redhotchili0909/LEDSphere/data/FET_dual_channel_summary.png

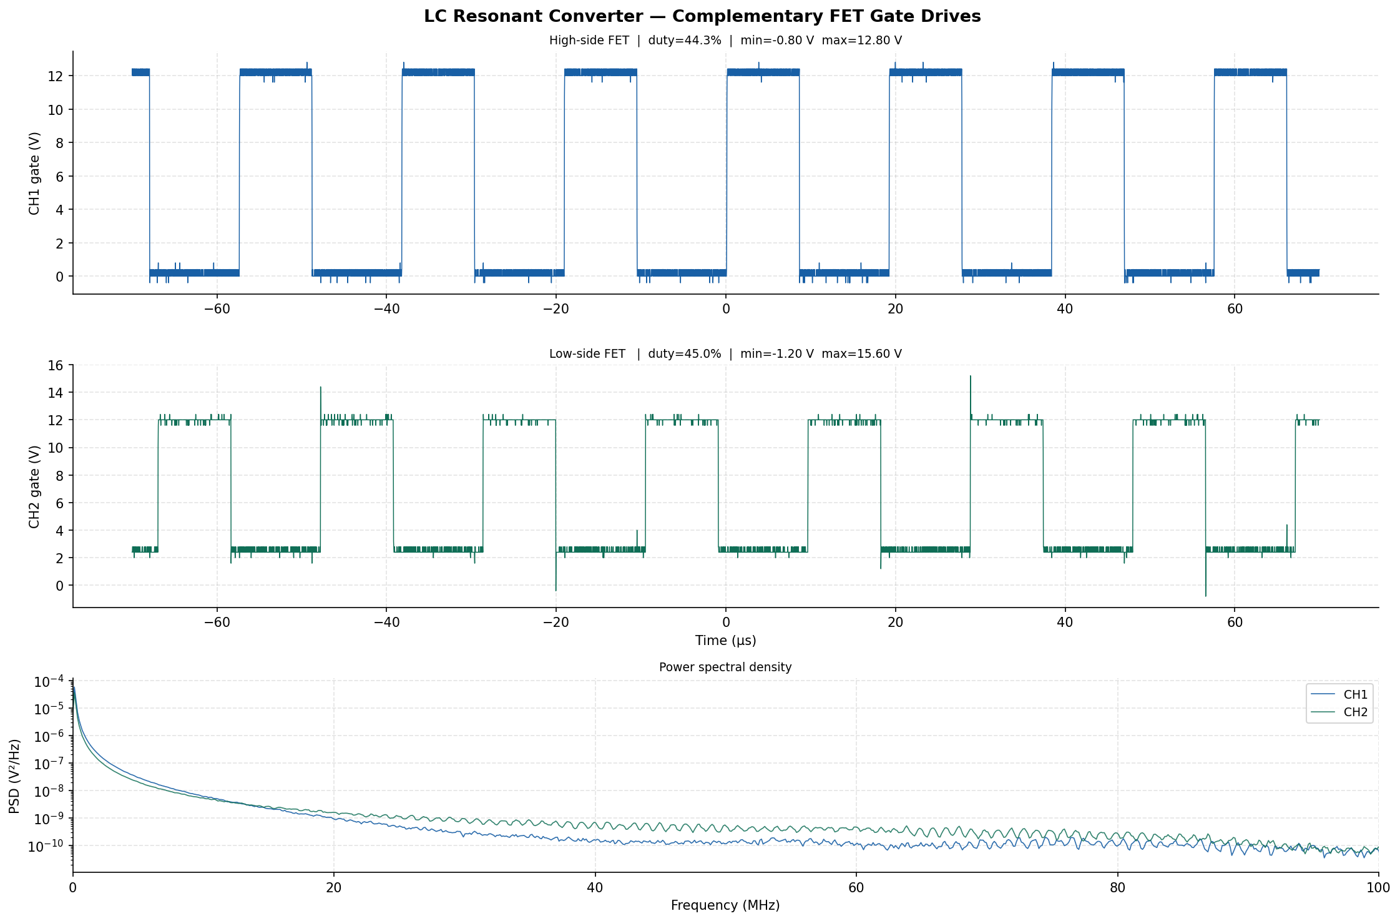
data/FET_dual_channel_summary.png
