redhotchili0909/LEDSphere/data/FET_full_analysis_summary.png

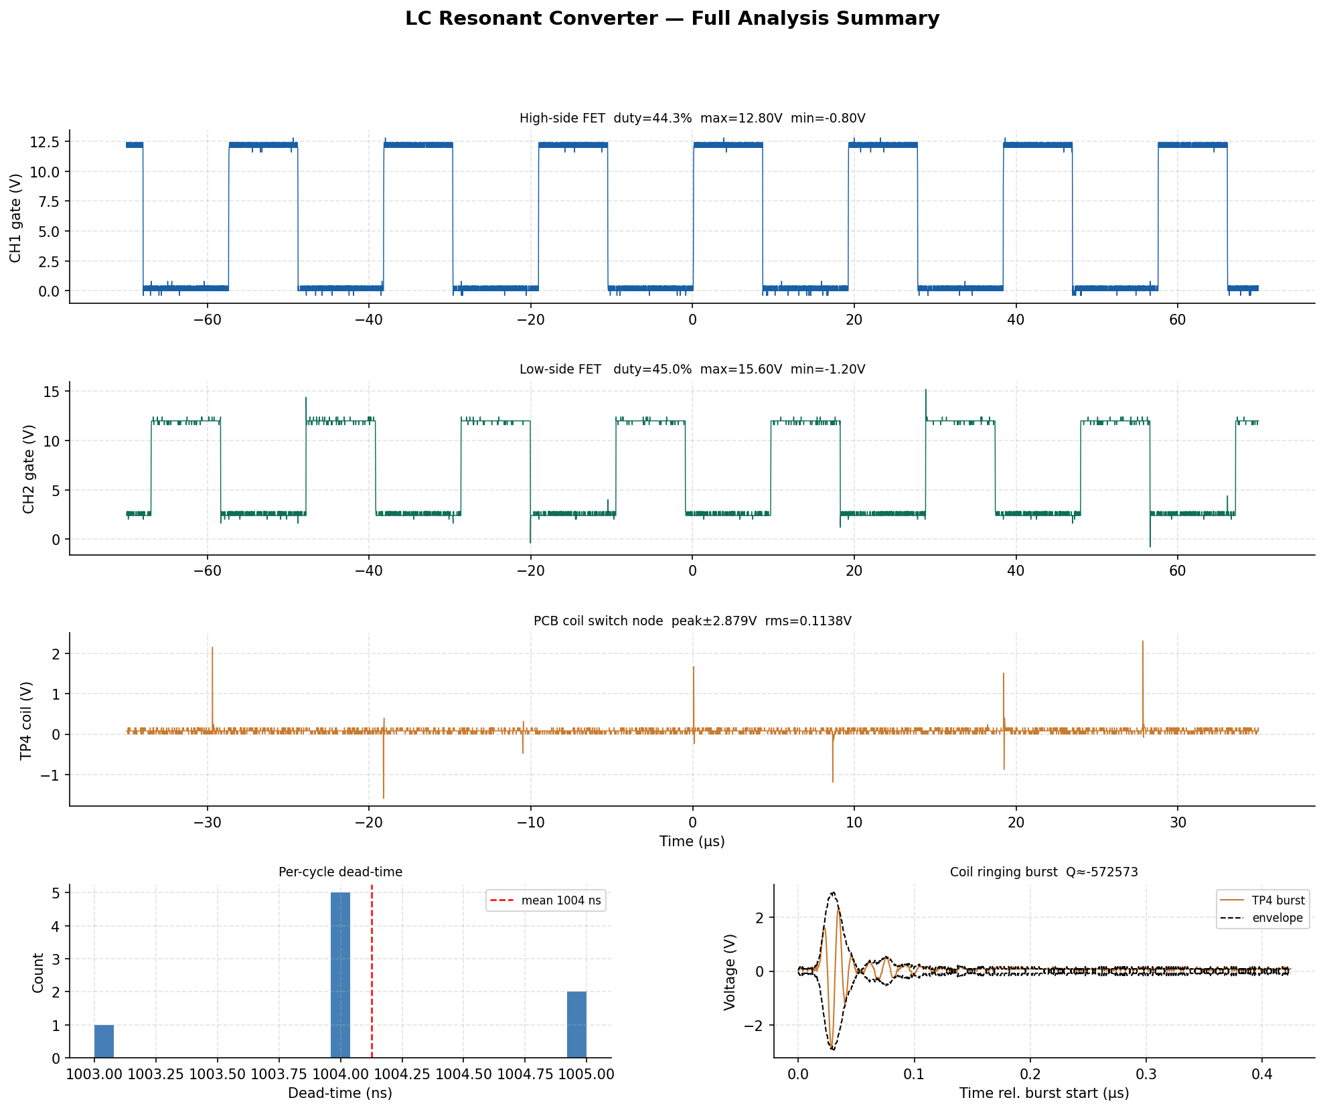
data/FET_full_analysis_summary.png
