redhotchili0909/LEDSphere/LEDSphere/pcb_models/rx.step

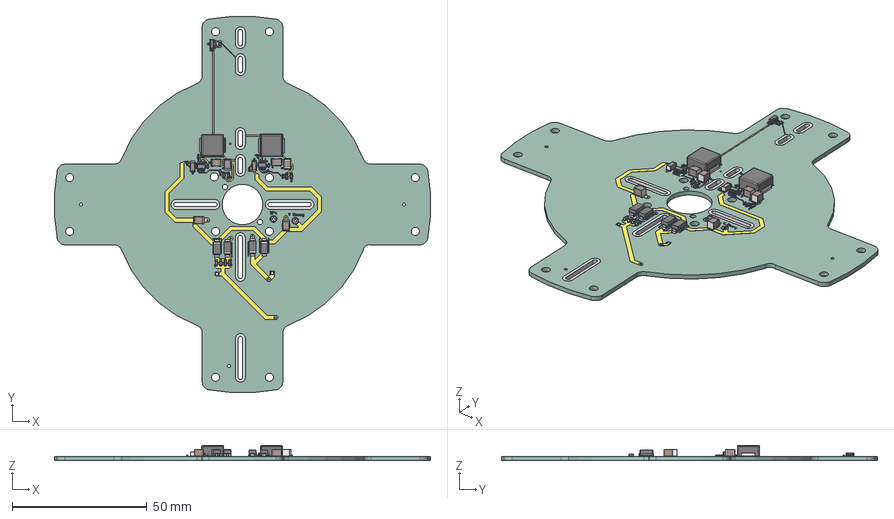
[picture p3: CAD file, 2026-04-09]
LEDSphere/pcb_models/rx.step
139.7 x 139.7 x 5.63 mm
C_1210_3225Metric x 6
C_0402_1005Metric x 7
C_0603_1608Metric x 4
D_SMA x 4
L_Vishay_IHLP-3232 x 2
R_0603_1608Metric x 5
R_0402_1005Metric x 2
TPS54202HDDCR x 2
SOT-23-3
C_1206_3216Metric x 2
power_rx_copper
power_rx_pad
power_rx_via
power_rx_silkscreen
power_rx_PCB
