redhotchili0909/LEDSphere/LEDSphere/pcb_models/support.step

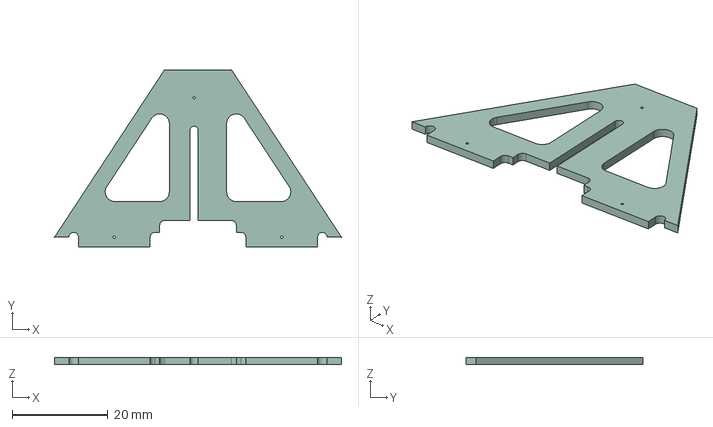
[picture p4: CAD file, 2026-04-09]
LEDSphere/pcb_models/support.step
60.0 x 37.1 x 1.51 mm
