redhotchili0909/LEDSphere/LEDSphere/Model3D/1217AS-H-150M_P3.step

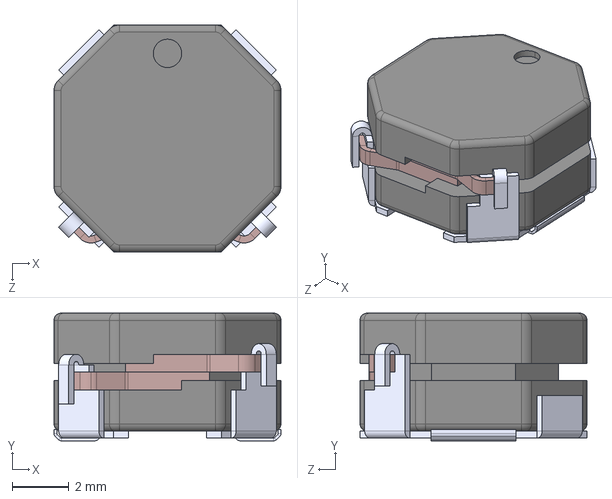
[picture p5: CAD file, 2026-04-05]
LEDSphere/Model3D/1217AS-H-150M_P3.step
8.00 x 4.50 x 8.00 mm
