redhotchili0909/LEDSphere/LEDSphere/Model3D/ASPI-0630LR-100M-T15.step

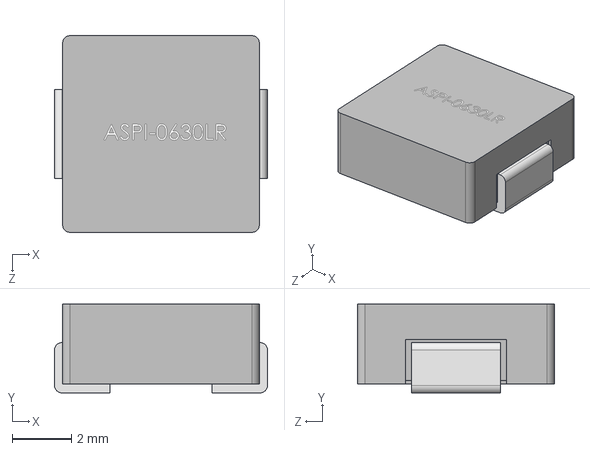
[picture p6: CAD file, 2026-04-03]
LEDSphere/Model3D/ASPI-0630LR-100M-T15.step
7.20 x 3.00 x 6.65 mm
