redhotchili0909/LEDSphere/LEDSphere/Model3D/tad05-03-1-l-g.stp

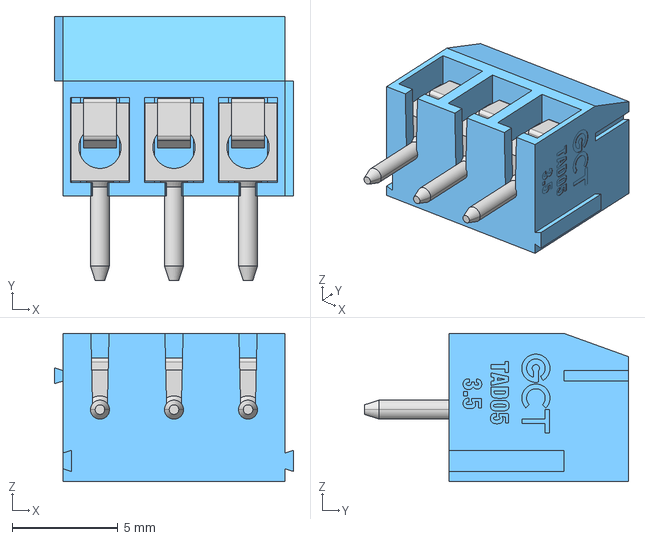
[picture p7: CAD file, 2026-04-03]
LEDSphere/Model3D/tad05-03-1-l-g.stp
11.3 x 12.5 x 7.00 mm
