redhotchili0909/LEDSphere/LEDSphere/Model3D/MSD-4-A.STEP

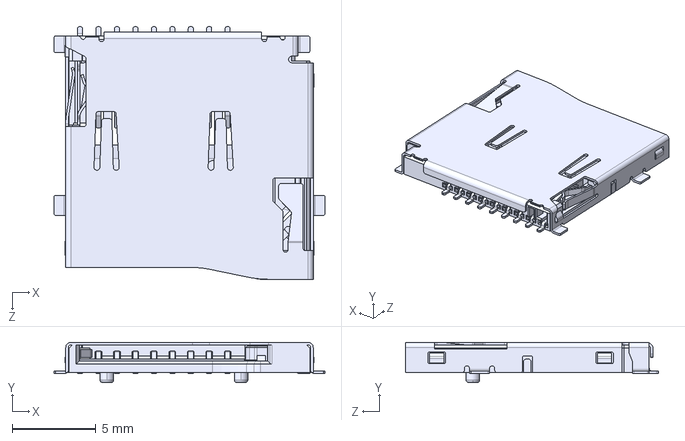
[picture p8: CAD file, 2026-04-03]
LEDSphere/Model3D/MSD-4-A.STEP
16.1 x 2.40 x 15.0 mm
