redhotchili0909/LEDSphere/LEDSphere/Model3D/SMC Package.step

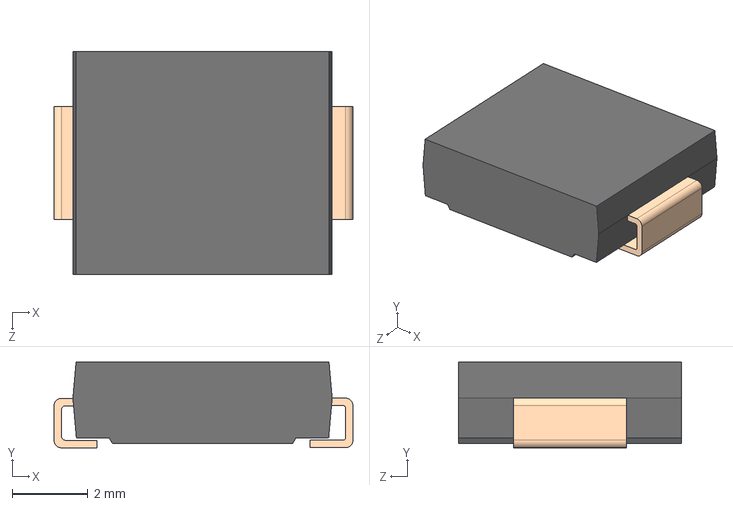
[picture p9: CAD file, 2026-04-02]
LEDSphere/Model3D/SMC Package.step
7.90 x 2.26 x 5.90 mm
