redhotchili0909/LEDSphere/LEDSphere/Model3D/D0014A.stp

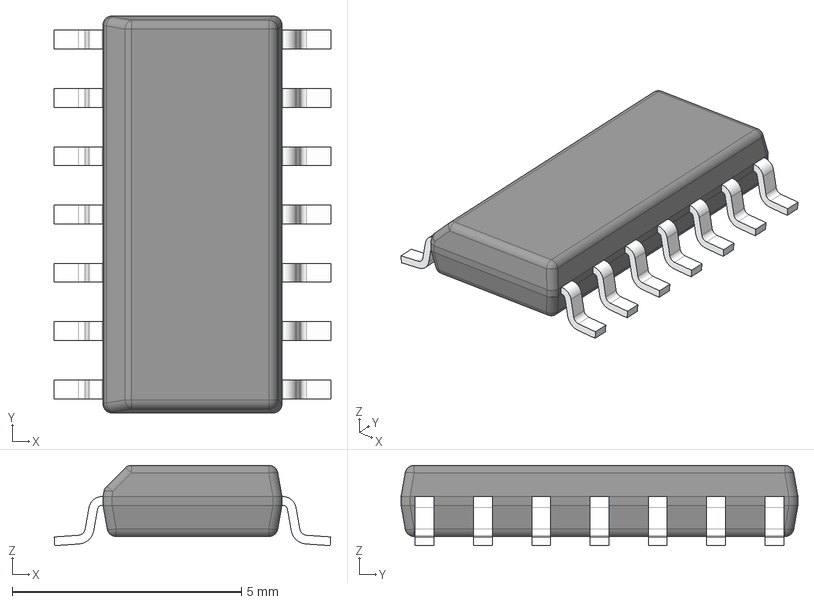
[picture p10: CAD file, 2026-04-02]
LEDSphere/Model3D/D0014A.stp
6.03 x 8.65 x 1.75 mm
BODY-SO
LEAD-SO x 14
PIN1-ID
