redhotchili0909/LEDSphere/LEDSphere/Model3D/xkb5858-w-f-75.stp

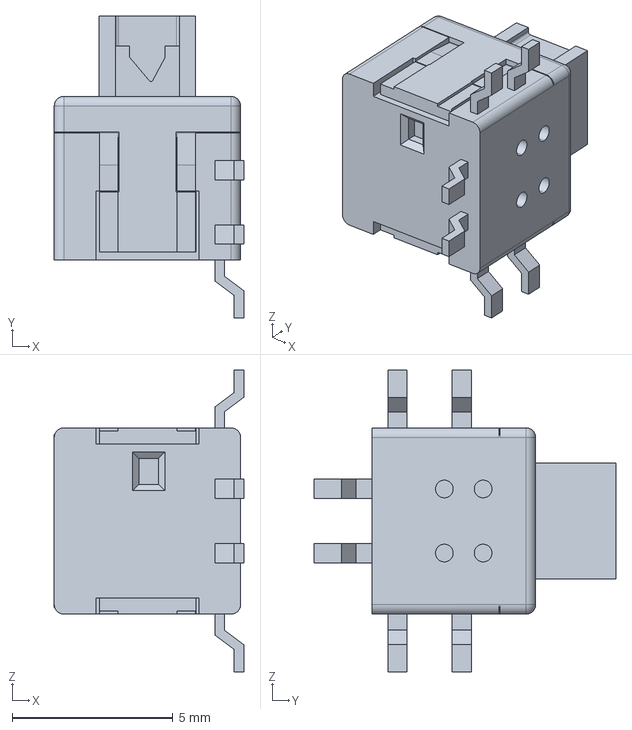
[picture p11: CAD file, 2026-04-02]
LEDSphere/Model3D/xkb5858-w-f-75.stp
5.90 x 9.40 x 9.40 mm
