redhotchili0909/LEDSphere/LEDSphere/Model3D/SO-16N_STM.step

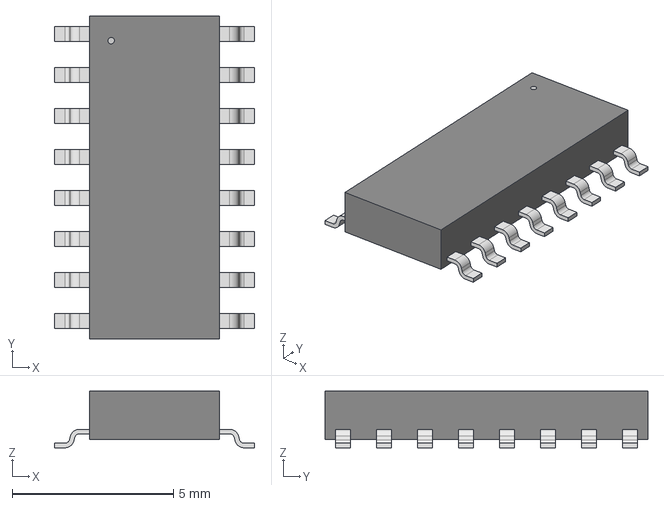
[picture p12: CAD file, 2026-04-02]
LEDSphere/Model3D/SO-16N_STM.step
6.20 x 10.0 x 1.75 mm
