redhotchili0909/LEDSphere/LEDSphere/Model3D/SRP 7028A series.stp

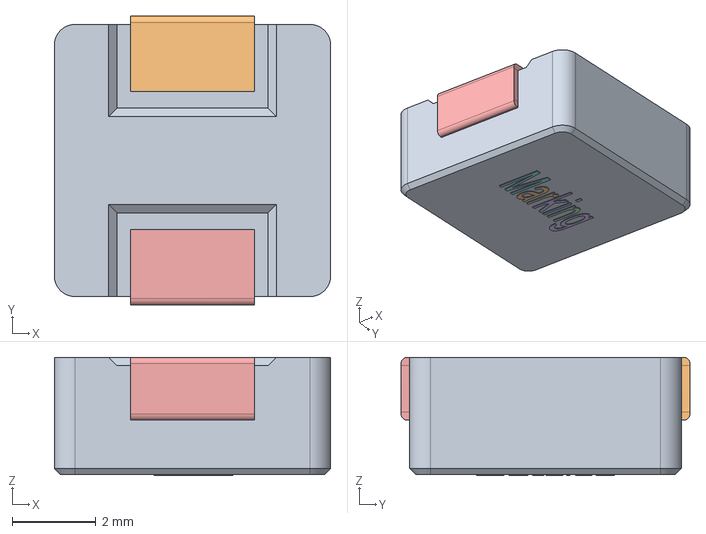
[picture p13: CAD file, 2026-04-02]
LEDSphere/Model3D/SRP 7028A series.stp
6.60 x 6.90 x 2.82 mm
