redhotchili0909/LEDSphere/LEDSphere/Model3D/D0016A.stp

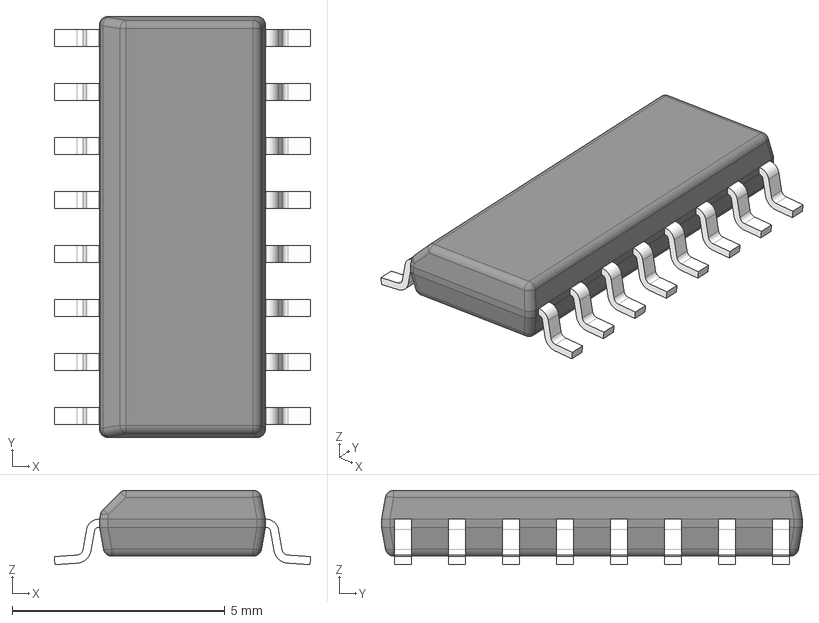
[picture p14: CAD file, 2026-04-02]
LEDSphere/Model3D/D0016A.stp
6.03 x 9.90 x 1.75 mm
BODY-SO
LEAD-SO x 16
PIN1-ID
