redhotchili0909/LEDSphere/LEDSphere/Model3D/SN74AHC1G14DBVR.step

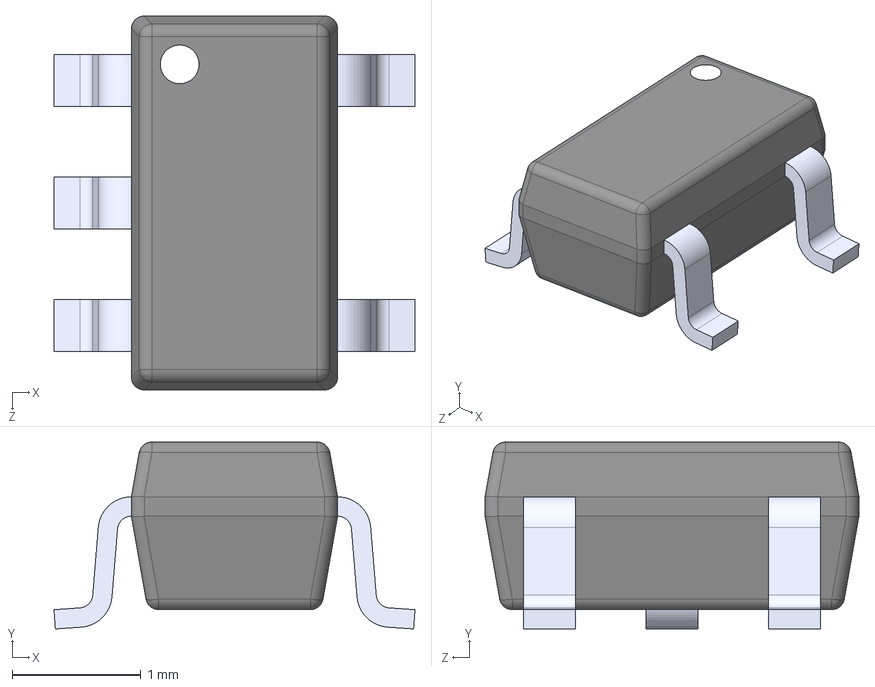
[picture p15: CAD file, 2026-04-02]
LEDSphere/Model3D/SN74AHC1G14DBVR.step
2.80 x 1.45 x 2.90 mm
