redhotchili0909/LEDSphere/LEDSphere/Model3D/UJ20-C-V-C-1-SMT-TR.STEP

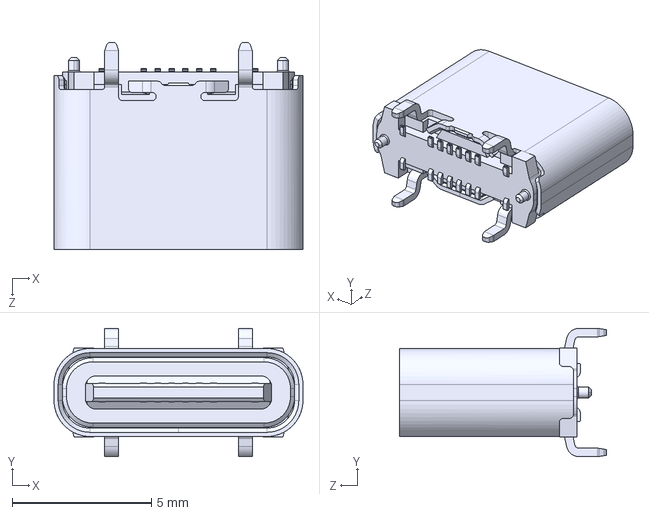
[picture p16: CAD file, 2026-03-26]
LEDSphere/Model3D/UJ20-C-V-C-1-SMT-TR.STEP
8.94 x 4.60 x 7.45 mm
