redhotchili0909/LEDSphere/LEDSphere/Model3D/SG3525AP.step

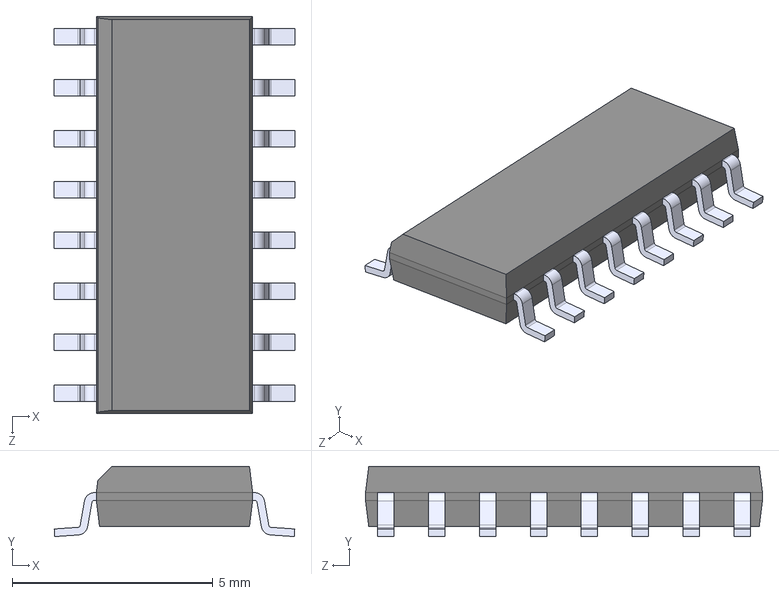
[picture p17: CAD file, 2026-03-25]
LEDSphere/Model3D/SG3525AP.step
6.00 x 1.75 x 9.90 mm
