redhotchili0909/LEDSphere/LEDSphere/Model3D/QFPN_491KCU6_STM.step

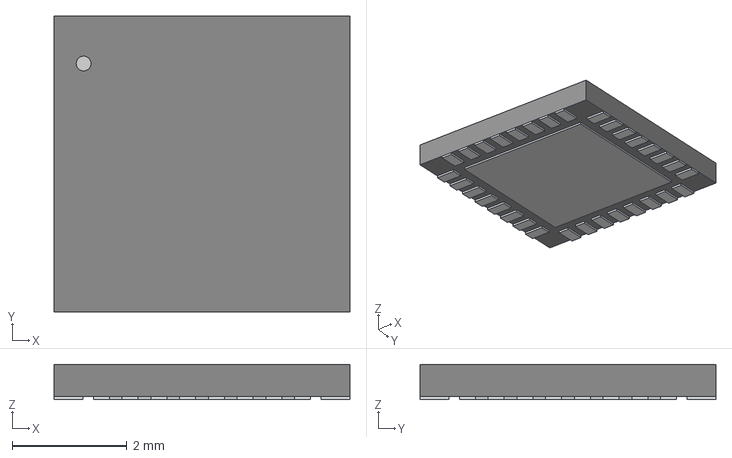
[picture p18: CAD file, 2026-03-24]
LEDSphere/Model3D/QFPN_491KCU6_STM.step
5.16 x 5.16 x 0.612 mm
