redhotchili0909/LEDSphere/LEDSphere/Model3D/1727036.stp

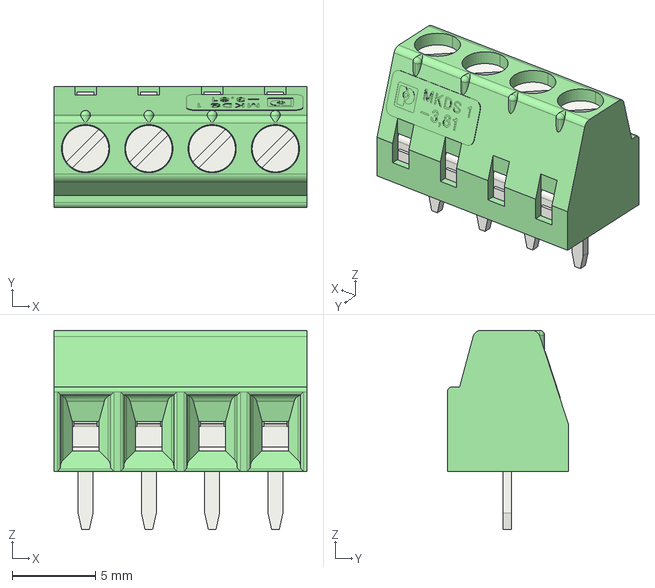
[picture p19: CAD file, 2026-04-14]
LEDSphere/Model3D/1727036.stp
15.2 x 7.30 x 12.0 mm
