redhotchili0909/LEDSphere/(list of files, cad)

Other CAD files:
LEDSphere/Model3D/SS34.step
LEDSphere/Model3D/3362P001XXX0A.stp
LEDSphere/Model3D/61030821821+%28rev1%29.stp
LEDSphere/Model3D/TPS54202HDDCR.step
