redhotchili0909/LEDSphere/LEDSphere/display_ctrler.kicad_pcb

## KiCad design LEDSphere/display_ctrler.kicad_pcb (2026-04-14)

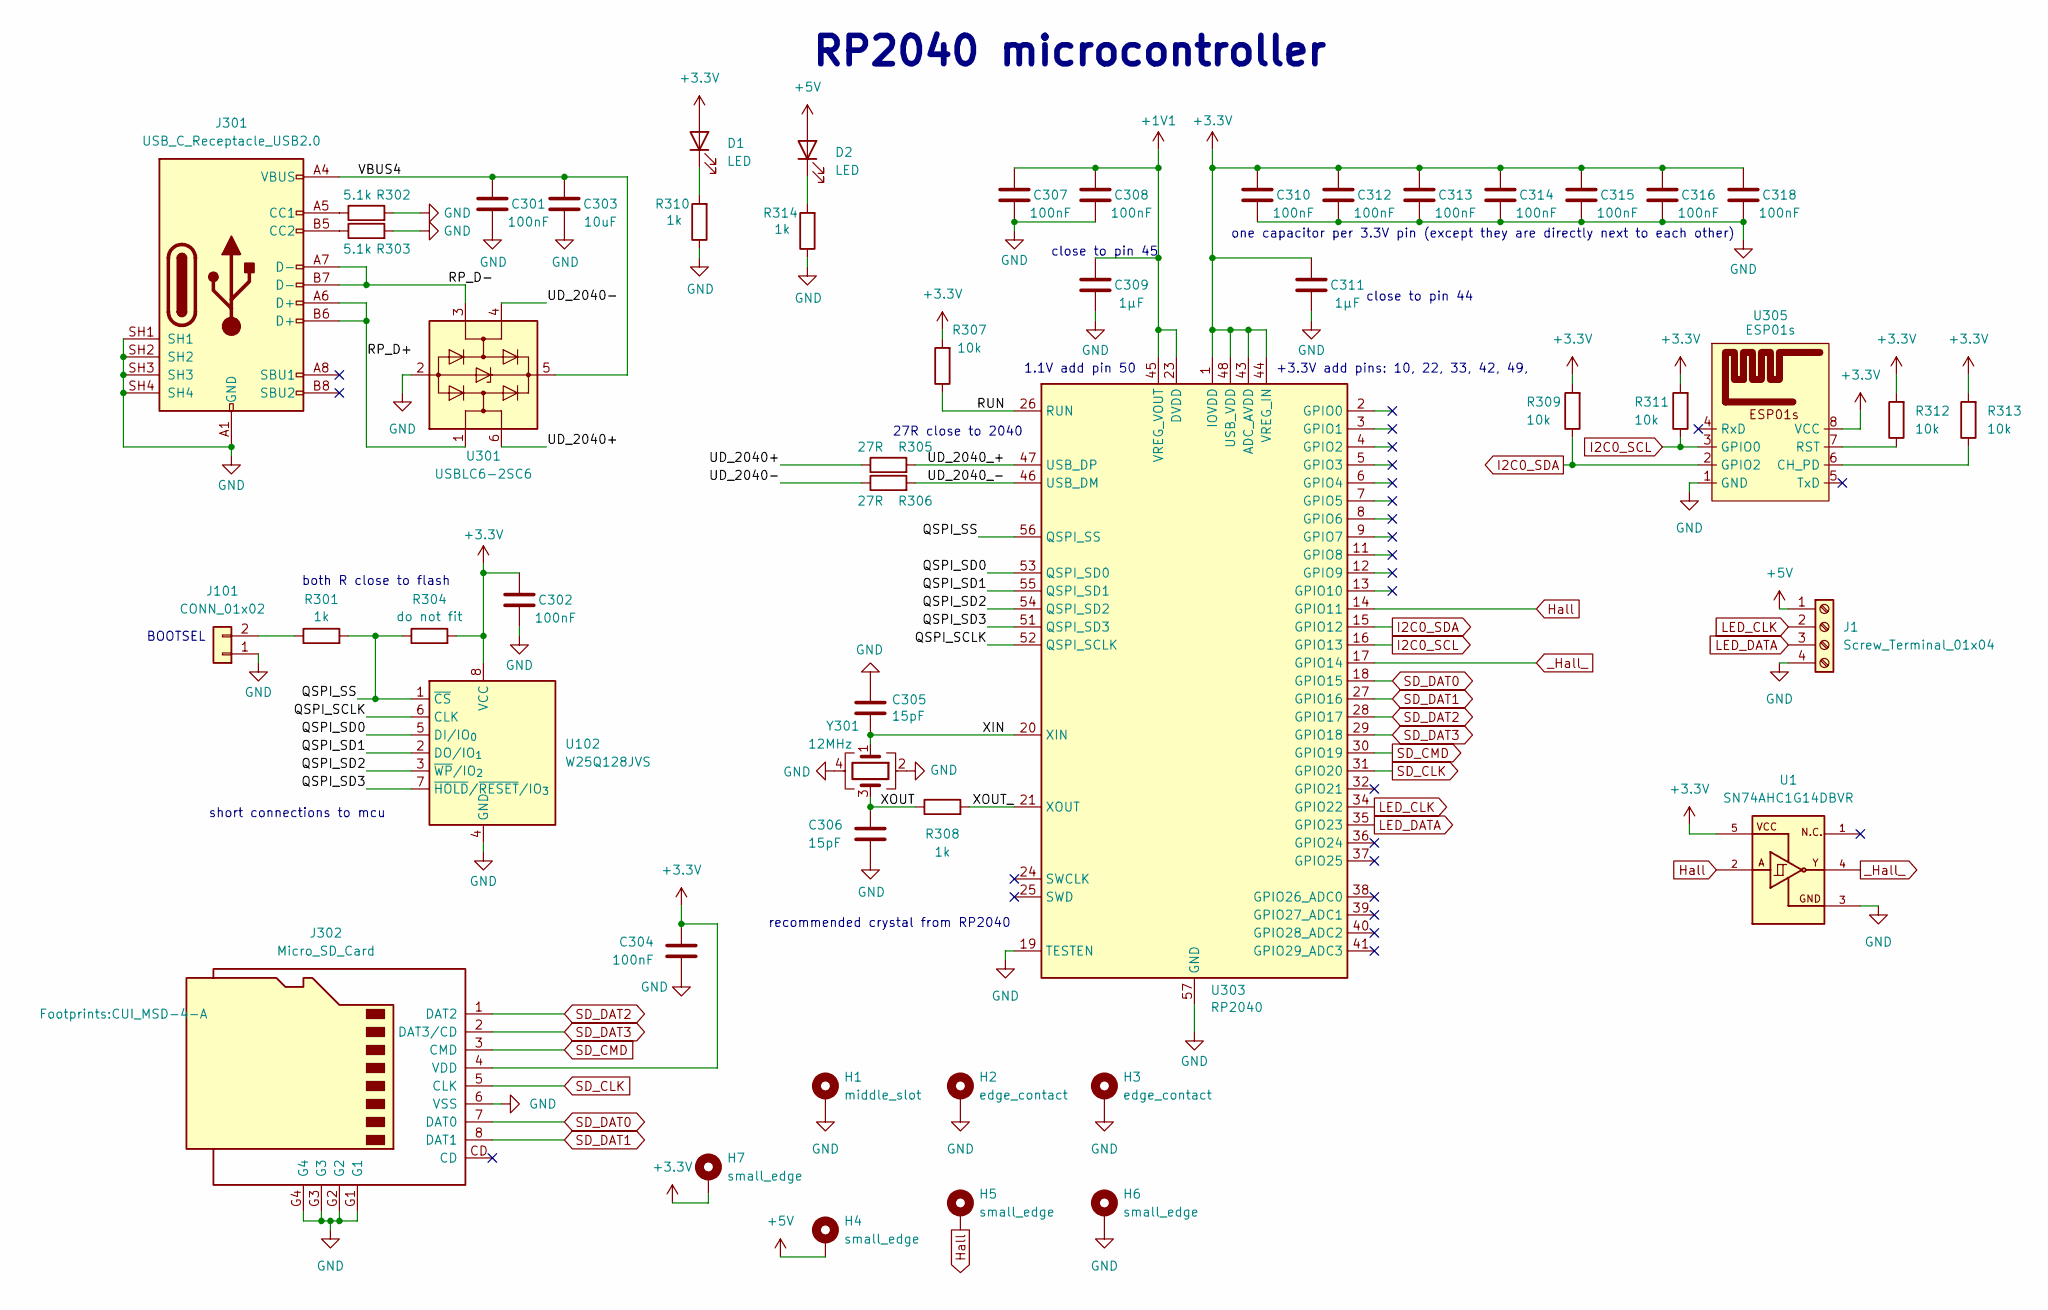
[picture p20: schematic display_ctrler.kicad_sch]

Parts:
C301, C302, C304, C310, C312, C313, C314, C315, C316: 100nF; C_0603_1608Metric; LCSC C307331
C303: 10uF; C_1206_3216Metric; LCSC C307331
C305, C306: 15pF; C_0603_1608Metric; LCSC C1557
C307, C308, C318: 100nF; C_0402_1005Metric; LCSC C307331
C309: 1µF; C_0402_1005Metric; LCSC C52923
C311: 1µF; C_0603_1608Metric; LCSC C52923
D1, D2: LED; LED_0805_2012Metric
H1: middle_slot
H2, H3: edge_contact
H4, H5, H6, H7: small_edge; edge_contact_small
J1: Screw_Terminal_01x04; PHOENIX_1727036
J101: CONN_01x02; PinHeader_1x02_P2.54mm_Vertical; MPN 732-5315-ND
J301: USB_C_Receptacle_USB2.0; CUI_UJ20-C-V-C-1-SMT-TR; LCSC C3001289
J302: Micro_SD_Card; CUI_MSD-4-A; LCSC C5155564
R301, R308: 1k; R_0603_1608Metric; LCSC C11702
R302, R303: 5.1k; R_0603_1608Metric; LCSC C25905
R304: do not fit; R_0603_1608Metric
R305, R306: 27R; R_0603_1608Metric; LCSC C321419
R307, R309, R311, R312, R313: 10k; R_0603_1608Metric; LCSC C25744
R310, R314: 1k; R_0603_1608Metric; LCSC C25744
U1: SN74AHC1G14DBVR; SOT-23-5; PARTREV Q
U102: W25Q128JVS; SOIC-8_5.3x5.3mm_P1.27mm
U301: USBLC6-2SC6; SOT-23-6; LCSC C2687116
U303: RP2040; QFN-56-1EP_7x7mm_P0.4mm_EP3.2x3.2mm; LCSC C2040
U305: ESP01s; ESP01s_SMD
Y301: 12MHz; Crystal_SMD_3225-4Pin_3.2x2.5mm; LCSC C9002

Connections:
+1V1: C307.2, C308.2, C309.2, U303.23 (DVDD), U303.45 (VREG_VOUT), U303.50 (DVDD)
+3.3V: C302.2, C304.1, C310.2, C311.2, C312.2, C313.2, C314.2, C315.2, C316.2, C318.2, D1.2 (A), H7.1 (1_1), J302.4 (VDD), R304.2, R307.2, R309.2, R311.2, R312.2, R313.2, U1.5, U102.8 (VCC), U303.1 (IOVDD), U303.10 (IOVDD), U303.22 (IOVDD), U303.33 (IOVDD), U303.42 (IOVDD), U303.43 (ADC_AVDD), U303.44 (VREG_IN), U303.48 (USB_VDD), U303.49 (IOVDD), U305.8 (VCC)
+5V: D2.2 (A), H4.1 (1_1), J1.1
/QSPI_SCLK: U102.6 (CLK), U303.52 (QSPI_SCLK)
/QSPI_SD0: U102.5 (DI/IO_{0}), U303.53 (QSPI_SD0)
/QSPI_SD1: U102.2 (DO/IO_{1}), U303.55 (QSPI_SD1)
/QSPI_SD2: U102.3 (~WP/IO_{2}), U303.54 (QSPI_SD2)
/QSPI_SD3: U102.7 (~HOLD/~RESET/IO_{3}), U303.51 (QSPI_SD3)
/QSPI_SS: R301.2, R304.1, U102.1 (~CS), U303.56 (QSPI_SS)
/RP_D+: J301.A6 (D+), J301.B6 (D+), U301.1 (I/O1)
/RP_D-: J301.A7 (D-), J301.B7 (D-), U301.3 (I/O2)
/RUN: R307.1, U303.26 (RUN)
/UD_2040+: R305.1, U301.6 (I/O1)
/UD_2040-: R306.1, U301.4 (I/O2)
/UD_2040_+: R305.2, U303.47 (USB_DP)
/UD_2040_-: R306.2, U303.46 (USB_DM)
/VBUS4: C301.2, C303.2, J301.A4 (VBUS), J301.A9 (VBUS), J301.B4 (VBUS), J301.B9 (VBUS), U301.5 (VBUS)
/XIN: C305.2, U303.20 (XIN), Y301.1
/XOUT: C306.1, R308.1, Y301.3
/XOUT_: R308.2, U303.21 (XOUT)
GND: C301.1, C302.1, C303.1, C304.2, C305.1, C306.2, C307.1, C308.1, C309.1, C310.1, C311.1, C312.1, C313.1, C314.1, C315.1, C316.1, C318.1, H1.1 (1_1), H2.1 (1_1), H3.1 (1_1), H6.1 (1_1), J1.4, J101.1, J301.A1 (GND), J301.A12 (GND), J301.B1 (GND), J301.B12 (GND), J301.SH1, J301.SH2, J301.SH3, J301.SH4, J302.6 (VSS), J302.G1, J302.G2, J302.G3, J302.G4, R302.2, R303.2, R310.1, R314.1, U1.3, U102.4 (GND), U301.2 (GND), U303.19 (TESTEN), U303.57 (GND), U305.1 (GND), Y301.2, Y301.4
Hall: H5.1 (1_1), U1.2, U303.14 (GPIO11)
I2C0_SCL: R311.1, U303.16 (GPIO13), U305.3 (GPIO0)
I2C0_SDA: R309.1, U303.15 (GPIO12), U305.2 (GPIO2)
LED_CLK: J1.2, U303.34 (GPIO22)
LED_DATA: J1.3, U303.35 (GPIO23)
unnamed: D1.1 (K), R310.2
unnamed: D2.1 (K), R314.2
unnamed: J101.2, R301.1
unnamed: J301.A5 (CC1), R302.1
unnamed: J301.B5 (CC2), R303.1
unnamed: R313.1, U305.6 (CH_PD)
unnamed: R312.1, U305.7 (RST)
SD_CLK: J302.5 (CLK), U303.31 (GPIO20)
SD_CMD: J302.3 (CMD), U303.30 (GPIO19)
SD_DAT0: J302.7 (DAT0), U303.18 (GPIO15)
SD_DAT1: J302.8 (DAT1), U303.27 (GPIO16)
SD_DAT2: J302.1 (DAT2), U303.28 (GPIO17)
SD_DAT3: J302.2 (DAT3/CD), U303.29 (GPIO18)
_Hall_: U1.4, U303.17 (GPIO14)

Notes on the sheet:
short connections to mcu
27R close to 2040
BOOTSEL
+3.3V add pins: 10, 22, 33, 42, 49,
1.1V add pin 50
close to pin 44
RP2040 microcontroller
one capacitor per 3.3V pin (except they are directly next to each other)
both R close to flash
close to pin 45
recommended crystal from RP2040

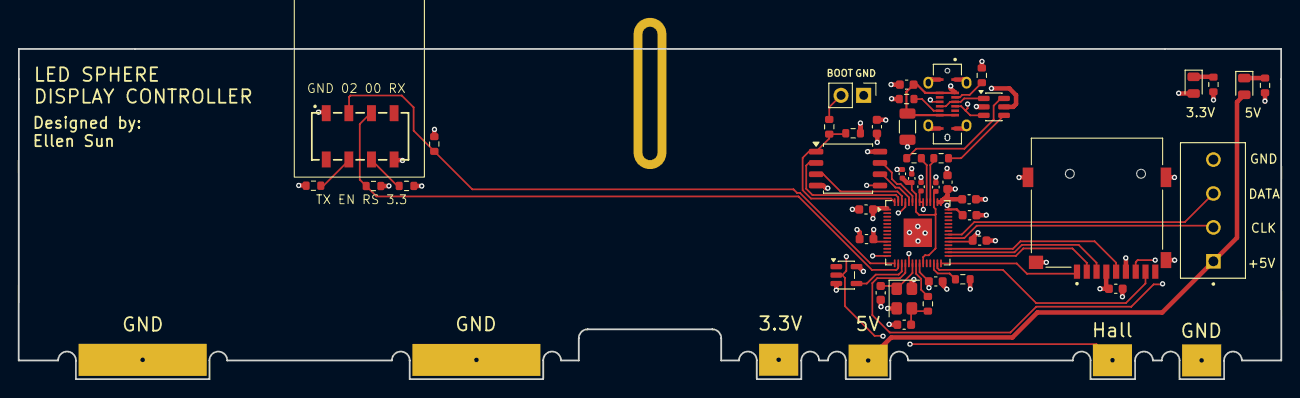
[picture p21: board display_ctrler.kicad_pcb from above]

Board: 4 copper layers, 141.9 x 37.1 mm, 50 parts (0 on the bottom side), 40 nets.
