redhotchili0909/LEDSphere/LEDSphere/power_rx.kicad_pcb

## KiCad design LEDSphere/power_rx.kicad_pcb (2026-04-14)

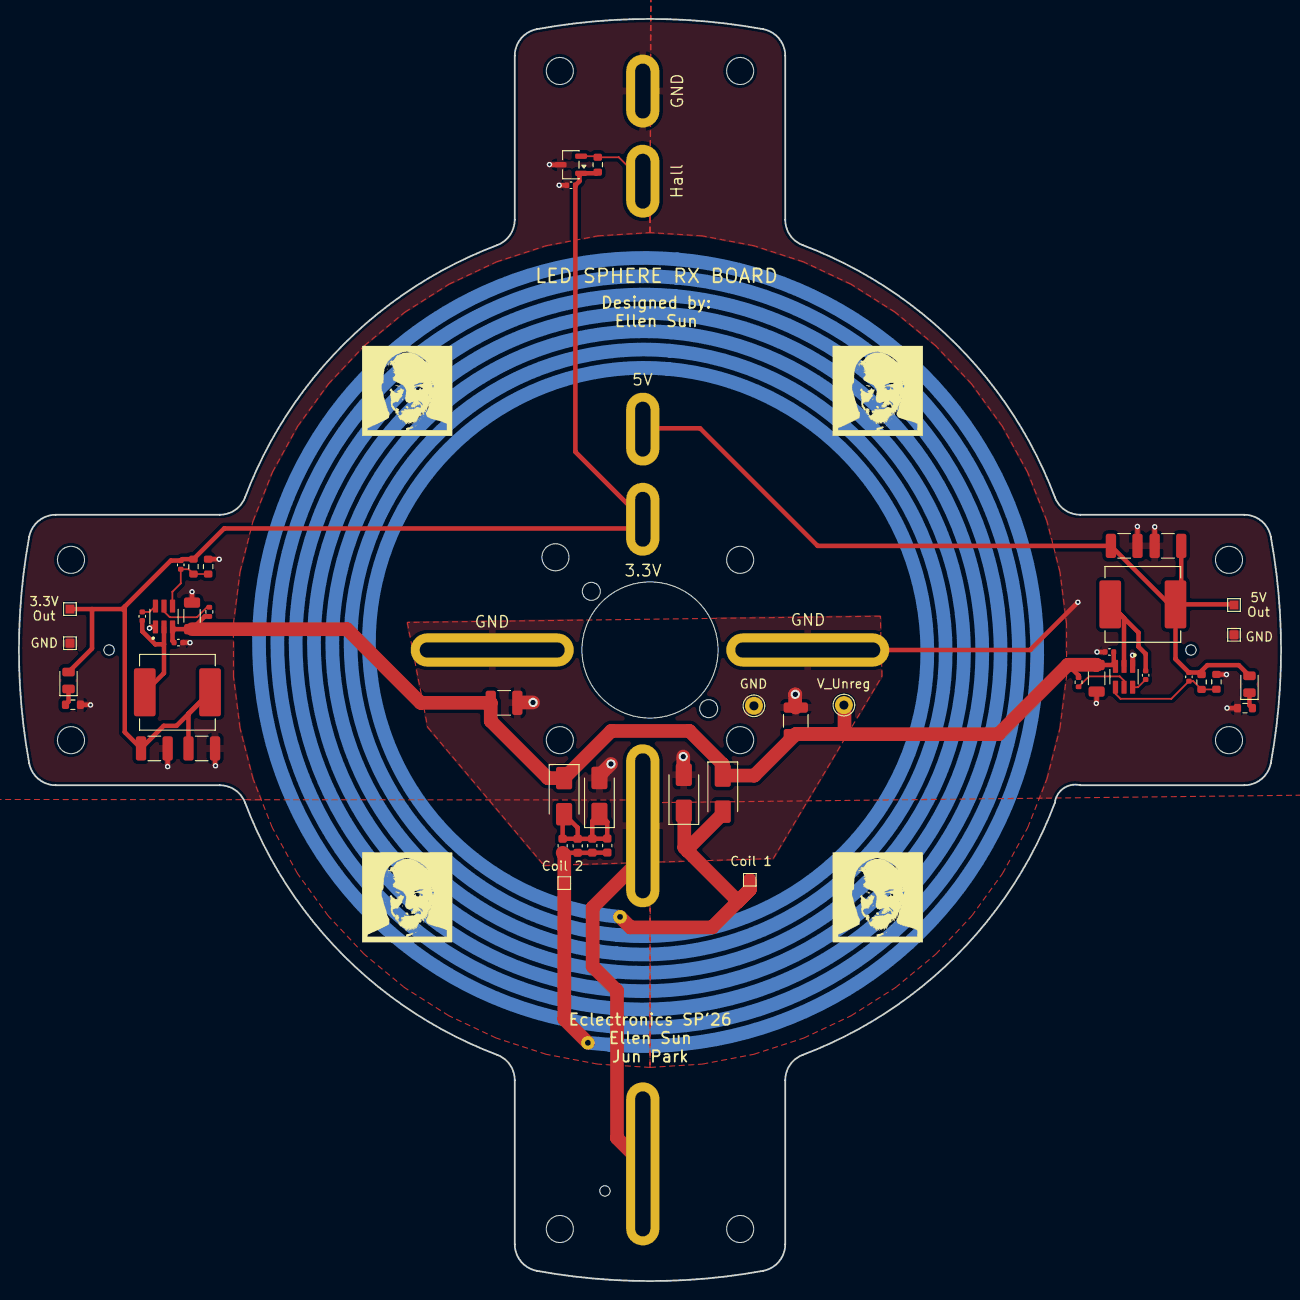
[picture p22: board power_rx.kicad_pcb from above]

Board: 2 copper layers, 140.0 x 140.0 mm, 55 parts (0 on the bottom side), 18 nets.

Parts:
C1, C2: 10uF; C_1206_3216Metric
C3, C4, C10, C11, C19: 100nF; C_0402_1005Metric
C5, C6, C7, C8: 100nF; C_0603_1608Metric
C9, C12, C13, C14, C15, C16: 22uF; C_1210_3225Metric
C17: 56pF; C_0402_1005Metric
C18: 75pF; C_0402_1005Metric
D1, D2, D3, D4: SS34; D_SMA
D5, D6: LED; LED_0805_2012Metric
L2: 10uH; L_Vishay_IHLP-3232
L3: 15uH; L_Vishay_IHLP-3232
R1, R2: 511k; R_0402_1005Metric
R3, R5: 100k; R_0603_1608Metric
R4: 22.1k; R_0603_1608Metric
R6: 13.3k; R_0603_1608Metric
R7: 10k; R_0603_1608Metric
R8, R9: 1k; R_0603_1608Metric
TP1: Coil2; TestPoint_Pad_1.0x1.0mm
TP2: Coil1; TestPoint_Pad_1.0x1.0mm
TP3: CoilOut; TestPoint_THTPad_D2.0mm_Drill1.0mm
TP4: GND; TestPoint_THTPad_D2.0mm_Drill1.0mm
TP5: 5V; TestPoint_Pad_1.0x1.0mm
TP6: 3.3V; TestPoint_Pad_1.0x1.0mm
TP7, TP8: GND; TestPoint_Pad_1.0x1.0mm
U3, U4: TPS54202HDDCR; SOT95P280X110-6N
U106, U111, U112, U113: slot_long
U107, U108, U109, U110: slot_short
U114: DRV5033FAQDBZR; SOT-23-3

Connections:
+3.3V: C13.2, C15.2, C17.2, C19.1, D5.2 (A), L2.2, R3.2, R7.1, TP6.1 (1_1), U110.1 (1_1), U114.1 (VCC)
+5V: C14.2, C16.2, C18.2, D6.2 (A), L3.2, R5.2, TP5.1 (1_1), U109.1 (1_1)
/U_unreg: C1.2, C2.2, C3.2, C4.2, C9.2, C12.2, D1.1 (K), D3.1 (K), R1.2, R2.2, TP3.1 (1_1), U3.3 (VIN), U4.3 (VIN)
/coil1: D3.2 (A), D4.1 (K), TP2.1 (1_1)
/coil2: C5.1, C6.1, C7.1, C8.1, TP1.1 (1_1)
GND: C1.1, C2.1, C3.1, C4.1, C9.1, C12.1, C13.1, C14.1, C15.1, C16.1, C19.2, D2.2 (A), D4.2 (A), R4.1, R6.1, R8.2, R9.2, TP4.1 (1_1), TP7.1 (1_1), TP8.1 (1_1), U3.1 (GND), U4.1 (GND), U106.1 (1_1), U107.1 (1_1), U111.1 (1_1), U112.1 (1_1), U113.1 (1_1), U114.3 (GND)
Hall: R7.2, U108.1 (1_1), U114.2 (OUT)
unnamed: C5.2, C6.2, C7.2, C8.2, D1.2 (A), D2.1 (K)
unnamed: D5.1 (K), R8.1
unnamed: D6.1 (K), R9.1
unnamed: C10.2, U3.6 (BOOT)
unnamed: R1.1, U3.5 (EN)
unnamed: C17.1, R3.1, R4.2, U3.4 (FB)
unnamed: C10.1, L2.1, U3.2 (SW)
unnamed: C11.2, U4.6 (BOOT)
unnamed: R2.1, U4.5 (EN)
unnamed: C18.1, R5.1, R6.2, U4.4 (FB)
unnamed: C11.1, L3.1, U4.2 (SW)
