redhotchili0909/LEDSphere/LEDSphere/power_tx.kicad_pcb

## KiCad design LEDSphere/power_tx.kicad_pcb (2026-04-09)

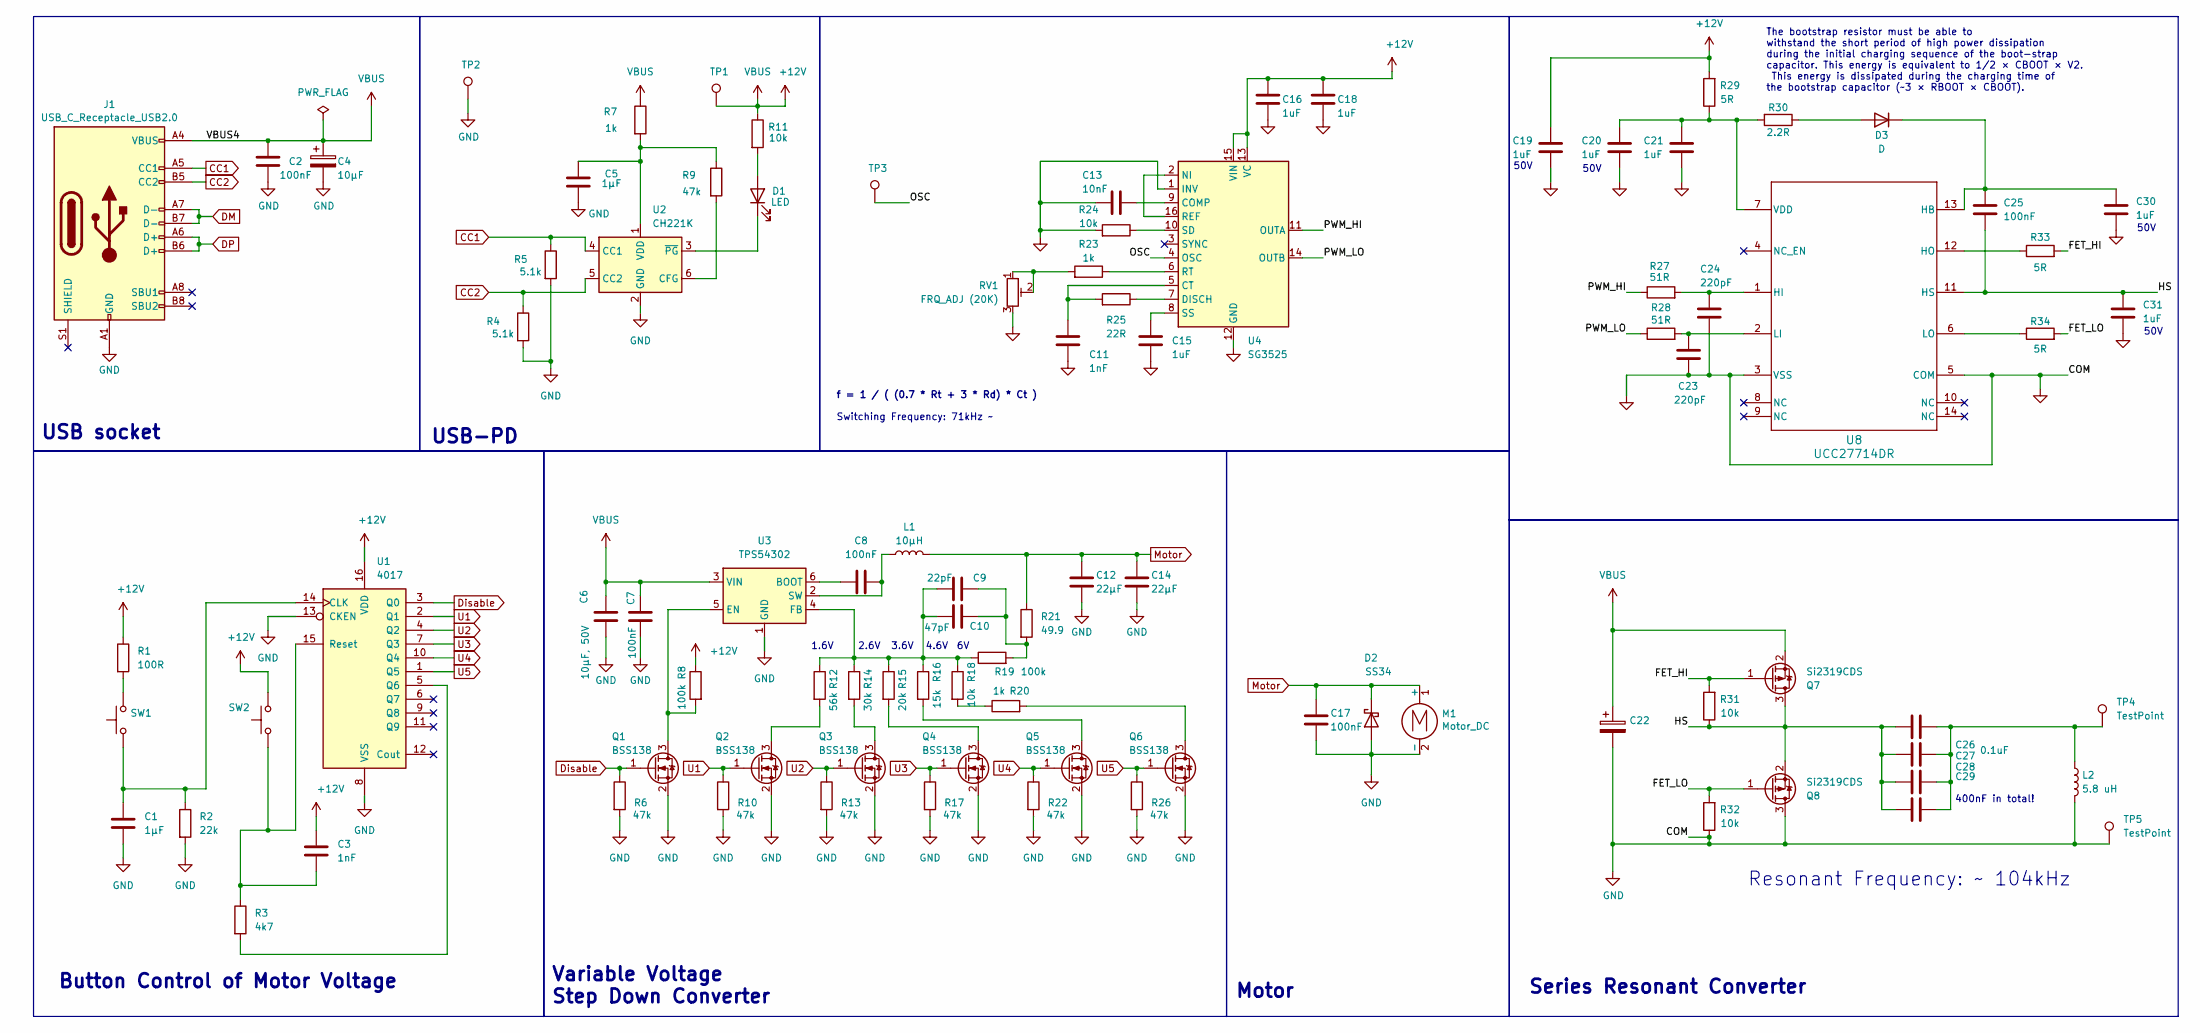
[picture p23: schematic power_tx.kicad_sch]

Parts:
C1, C5: 1µF; C_0603_1608Metric; LCSC C15849
C2: 100nF; C_0402_1005Metric; LCSC C307331
C3: 1nF; C_0402_1005Metric; LCSC C1523
C4: 10µF; C_0805_2012Metric; LCSC C440198
C6: 10µF, 50V; C_1206_3216Metric; LCSC C13585
C7, C8, C17, C27: 100nF; C_0603_1608Metric; LCSC C14663
C9: 22pF; C_0603_1608Metric; LCSC C1653
C10: 47pF; C_0603_1608Metric; LCSC C1671
C11: 1nF; C_0603_1608Metric
C12, C14: 22µF; C_1210_3225Metric; LCSC C45783
C13: 10nF; C_0603_1608Metric
C15: 1uF; C_0402_1005Metric
C16, C18, C20, C30, C31: 1uF; C_0805_2012Metric
C19: 1uF; C_1206_3216Metric
C21: 1uF; C_0603_1608Metric
C22: 10µ, 50V; C_1206_3216Metric; LCSC C13585
C23, C24: 220pF; C_0402_1005Metric
C25: 100nF; C_0603_1608Metric
C26: 0.1uF; C_0603_1608Metric; LCSC C14663
C28, C29: 68nF; C_0603_1608Metric; LCSC C14663
D1: LED; LED_0805_2012Metric; LCSC LSM0805412V
D2: SS34; D_SMA; LCSC C8678
D3: D; D_SMA
J1: USB_C_Receptacle_USB2.0; USB_C_Receptacle_GCT_USB4105-xx-A_16P_TopMnt_Horizontal; LCSC C709357
L1: 10µH; L_Vishay_IHLP-3232
L2: 5.8 uH; power_coil
M1: Motor_DC; motor
Q1: BSS138; SOT-23
Q2, Q3, Q4, Q5, Q6: BSS138; SOT-23; LCSC C7420339
Q7, Q8: Si2319CDS; SOT-23
R1: 100R; R_0402_1005Metric; LCSC C25076
R2: 22k; R_0402_1005Metric; LCSC C25768
R3: 4k7; R_0402_1005Metric; LCSC C25900
R4, R5: 5.1k; R_0402_1005Metric; LCSC C25744
R6, R10, R13, R17, R22, R26: 47k; R_0402_1005Metric; LCSC C25792
R7, R20: 1k; R_0402_1005Metric; LCSC C11702
R8, R19: 100k; R_0402_1005Metric; LCSC C25741
R9: 47k; R_0402_1005Metric; LCSC C25744
R11: 10k; R_0603_1608Metric; LCSC C21190
R12: 56k; R_0603_1608Metric; LCSC C23206
R14: 30k; R_0603_1608Metric; LCSC C22984
R15: 20k; R_0402_1005Metric; LCSC C25765
R16: 15k; R_0402_1005Metric; LCSC C25756
R18: 10k; R_0402_1005Metric; LCSC C25744
R21: 49.9; R_0402_1005Metric; LCSC C25120
R23: 1k; R_0402_1005Metric
R24: 10k; R_0402_1005Metric
R25: 22R; R_0402_1005Metric
R27, R28: 51R; R_0603_1608Metric
R29, R33, R34: 5R; R_0603_1608Metric
R30: 2.2R; R_0603_1608Metric
R31, R32: 10k; R_0603_1608Metric
RV1: FRQ_ADJ (20K); TRIM_3362P-1-203LF
SW1, SW2: SW_Push; SW_Tactile_SPST_Angled_PTS645Vx58-2LFS; Part # PTS645VK58-2 LFS
TP1, TP2, TP3: TestPoint; TestPoint_THTPad_D2.0mm_Drill1.0mm
TP4, TP5: TestPoint; TestPoint_Pad_1.0x1.0mm
U1: 4017; STC_SOP-16_3.9x9.9mm_P1.27mm; Part # CD4017BM96
U2: CH221K; SOT-23-6
U3: TPS54302; SOT-23-6; LCSC C311983
U4: SG3525; SO-16N_STM
U8: UCC27714DR; SOIC127P600X175-14N

Connections:
+12V: C2.2, C3.1, C4.1, C6.1, C7.1, C16.1, C18.1, C19.1, C22.1, J1.A4 (VBUS), J1.A9 (VBUS), J1.B4 (VBUS), J1.B9 (VBUS), Q7.2 (S), R1.1, R7.1, R8.1, R11.1, R29.2, SW2.2, TP1.1 (1_1), U1.16 (VDD), U3.3 (VIN), U4.13 (VC), U4.15 (VIN)
/FET_HI: Q7.1 (G), R31.2, R33.2
/FET_LO: Q8.1 (G), R32.2, R34.2
/HS: C25.2, C26.1, C27.1, C28.1, C29.1, C31.1, Q7.3 (D), Q8.2 (S), R31.1, U8.11 (HS)
/OSC: TP3.1 (1_1), U4.4 (OSC)
/PWM_HI: R27.1, U4.11 (OUTA)
/PWM_LO: R28.1, U4.14 (OUTB)
CC1: J1.A5 (CC1), R5.1, U2.4 (CC1)
CC2: J1.B5 (CC2), R4.1, U2.5 (CC2)
DM: J1.A7 (D-), J1.B7 (D-)
DP: J1.A6 (D+), J1.B6 (D+)
Disable: Q1.1 (G), R6.1, U1.3 (Q0)
GND: C1.2, C2.1, C4.2, C5.2, C6.2, C7.2, C11.2, C12.2, C13.1, C14.2, C15.2, C16.2, C17.2, C18.2, C19.2, C20.2, C21.2, C22.2, C23.2, C24.2, C30.2, C31.2, D2.2 (A), J1.A1 (GND), J1.A12 (GND), J1.B1 (GND), J1.B12 (GND), L2.2, M1.2 (-), Q1.2 (S), Q2.2 (S), Q3.2 (S), Q4.2 (S), Q5.2 (S), Q6.2 (S), Q8.3 (D), R2.2, R4.2, R5.2, R6.2, R10.2, R13.2, R17.2, R22.2, R24.2, R26.2, R32.1, RV1.3, TP2.1 (1_1), TP5.1 (1_1), U1.8 (VSS), U1.13 (CKEN), U2.2 (GND), U3.1 (GND), U4.1 (INV), U4.12 (GND), U8.3 (VSS), U8.5 (COM)
Motor: C12.1, C14.1, C17.1, D2.1 (K), L1.2, M1.1 (+), R21.1
unnamed: C9.2, C10.2, R19.2, R21.2
unnamed: C26.2, C27.2, C28.2, C29.2, L2.1, TP4.1 (1_1)
unnamed: D1.2 (A), R11.2
unnamed: D1.1 (K), U2.3 (~PG)
unnamed: D3.2 (A), R30.1
unnamed: C25.1, C30.1, D3.1 (K), U8.13 (HB)
unnamed: Q1.3 (D), R8.2, U3.5 (EN)
unnamed: Q2.3 (D), R12.2
unnamed: Q3.3 (D), R14.2
unnamed: Q4.3 (D), R15.2
unnamed: Q5.3 (D), R16.2
unnamed: Q6.3 (D), R20.2
unnamed: R1.2, SW1.2
unnamed: R18.2, R20.1
unnamed: R23.2, RV1.1, RV1.2
unnamed: C1.1, R2.1, SW1.1, U1.14 (CLK)
unnamed: R3.2, U1.5 (Q6)
unnamed: C3.2, R3.1, SW2.1, U1.15 (Reset)
unnamed: R9.2, U2.6 (CFG)
unnamed: C5.1, R7.2, R9.1, U2.1 (VDD)
unnamed: C8.1, U3.6 (BOOT)
unnamed: C9.1, C10.1, R12.1, R14.1, R15.1, R16.1, R18.1, R19.1, U3.4 (FB)
unnamed: C8.2, L1.1, U3.2 (SW)
unnamed: C13.2, U4.9 (COMP)
unnamed: C11.1, R25.2, U4.5 (CT)
unnamed: R25.1, U4.7 (DISCH)
unnamed: U4.2 (NI), U4.16 (REF)
unnamed: R23.1, U4.6 (RT)
unnamed: R24.1, U4.10 (SD)
unnamed: C15.1, U4.8 (SS)
unnamed: C24.1, R27.2, U8.1 (HI)
unnamed: R33.1, U8.12 (HO)
unnamed: C23.1, R28.2, U8.2 (LI)
unnamed: R34.1, U8.6 (LO)
unnamed: C20.1, C21.1, R29.1, R30.2, U8.7 (VDD)
U1: Q2.1 (G), R10.1, U1.2 (Q1)
U2: Q3.1 (G), R13.1, U1.4 (Q2)
U3: Q4.1 (G), R17.1, U1.7 (Q3)
U4: Q5.1 (G), R22.1, U1.10 (Q4)
U5: Q6.1 (G), R26.1, U1.1 (Q5)

Notes on the sheet:
Button Control of Motor Voltage
50V
f = 1 / ( (0.7 * Rt + 3 * Rd) * Ct )
2.6V
Variable Voltage Step Down Converter
Series Resonant Converter
Motor
Resonant Frequency: ~ 104kHz
3.6V
USB-PD
1.6V
Switching Frequency: 71kHz ~
4.6V
400nF in total!
USB socket
The bootstrap resistor must be able to withstand the short period of high power dissipation during the initial charging sequence of the boot-strap capacitor. This energy is equivalent to 1/2 × CBOOT × V2. This energy is dissipated during the charging time of the bootstrap capacitor (~3 × RBOOT × CB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

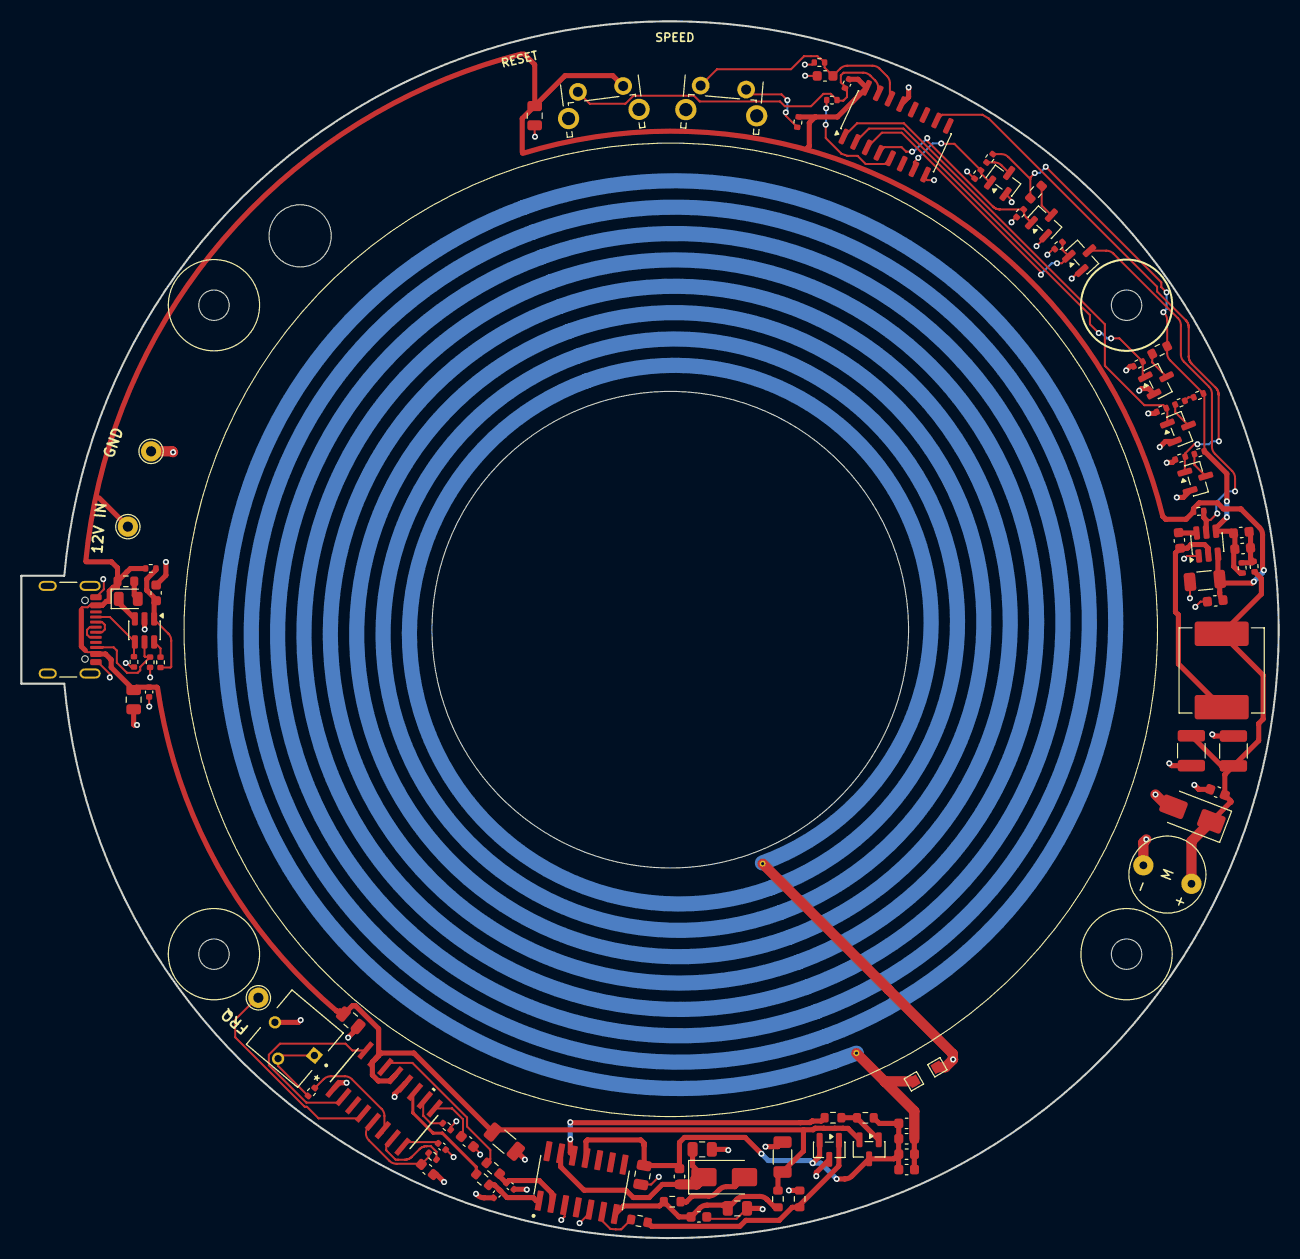
[picture p24: board power_tx.kicad_pcb from above]

Board: 2 copper layers, 124.0 x 120.0 mm, 93 parts (1 on the bottom side), 54 nets.
