redhotchili0909/LEDSphere/(commit log)

2026-03-24 Add Initial Power Board Transmitter Design
    [LEDSphere.kicad_sch, QFPN_491KCU6_STM.step, power_tx.kicad_pcb, power_tx.kicad_sch]
2026-03-25 started routing drivers, power mosfets
    [power_tx.kicad_sch]
2026-03-25 finished usb-c power delivery aspect - started pwm generator sch
    [LEDSphere.kicad_sch, SG3525AP.step, power_tx.kicad_sch]
2026-03-26 display controller sch
    [display_ctrler.kicad_pcb, display_ctrler.kicad_sch]
2026-03-26 finish schm
    [display_ctrler.kicad_sch]
2026-03-26 create receiver board proj
    [rx_board.kicad_pcb, rx_board.kicad_sch]
2026-03-26 first draft of power board
    [power_tx.kicad_sch]
2026-03-26 edit power mosfet orientation
    [power_tx.kicad_sch]
2026-03-26 renamed rx_board project to power_rx
    [power_rx.kicad_pcb, power_rx.kicad_sch]
2026-03-26 Add Power Transmitter Footprints
2026-03-26 Add Initial Schematic for Review
    [power_tx.kicad_sch]
2026-03-26 start power rx
    [3_3V_reg.kicad_sch, 5v_reg.kicad_sch, display_ctrler.kicad_sch, power_rx.kicad_sch, rx_coil.kicad_sch]
2026-03-27 hall effect sensor
    [power_rx.kicad_sch, rx_coil.kicad_sch]
2026-03-30 Add PCB Coil for Transmitter
    [power_tx.kicad_pcb, power_tx.kicad_sch]
2026-03-31 Starting Layout
    [power_tx.kicad_pcb, power_tx.kicad_sch]
2026-03-31 Start Layout
    [power_tx.kicad_pcb]
2026-03-31 Initial Layout (Rounded Tracks)
    [power_tx.kicad_pcb, power_tx.kicad_sch]
2026-03-31 Excluded Ground Pour
    [3362P001XXX0A.stp, D0014A.stp, D0016A.stp, SO-16N_STM.step, SRP 7028A series.stp, SS34.step, power_tx.kicad_pcb, power_tx.kicad_sch]
2026-04-02 start disp pcb layout
    [display_ctrler.kicad_pcb, display_ctrler.kicad_sch]
2026-04-02 Arrange file structure
    [3_3V_reg.kicad_sch, 5v_reg.kicad_sch, SMC Package.step, SN74AHC1G14DBVR.step, TPS54202HDDCR.step, UJ20-C-V-C-1-SMT-TR.STEP, display_ctrler.kicad_pcb, display_ctrler.kicad_sch]
2026-04-02 Remove power_rx directory
2026-04-02 finish display controller layout
    [display_ctrler.kicad_pcb, display_ctrler.kicad_sch]
2026-04-03 display controller add led terminal
    [MSD-4-A.STEP, display_ctrler.kicad_pcb, display_ctrler.kicad_sch, tad05-03-1-l-g.stp]
2026-04-03 adjust positions
    [display_ctrler.kicad_pcb]
2026-04-03 Modify RX Schm. + Adjusted TX Coil
    [3_3V_reg.kicad_sch, 5v_reg.kicad_sch, ASPI-0630LR-100M-T15.step, power_rx.kicad_pcb, power_rx.kicad_sch, power_tx.kicad_pcb, power_tx.kicad_sch, rx_coil.kicad_sch]
2026-04-03 Updated Resonance FRQ + Test Points Added
    [power_tx.kicad_pcb]
2026-04-05 move edge connections to correct area
    [display_ctrler.kicad_pcb]
2026-04-05 first draft rx power layout
    [1217AS-H-150M_P3.step, power_rx.kicad_pcb, power_rx.kicad_sch]
2026-04-05 Most Recent TX Board Changes
    [power_tx.kicad_pcb, power_tx.kicad_sch]
2026-04-05 Minor Layout Changes for TX Board
    [power_tx.kicad_pcb]
2026-04-07 change footprints
    [display_ctrler.kicad_pcb, display_ctrler.kicad_sch, power_rx.kicad_sch]
2026-04-07 Altered Button Part
    [power_tx.kicad_pcb, power_tx.kicad_sch]
2026-04-07 power rx layout change
    [power_rx.kicad_pcb, power_rx.kicad_sch]
2026-04-08 change hall effect sensor
    [power_rx.kicad_pcb, power_rx.kicad_sch]
2026-04-08 add in esp10s receptable
    [61030821821+%28rev1%29.stp, display_ctrler.kicad_pcb]
2026-04-08 Edit 22uF Footprint to 1210
    [power_tx.kicad_pcb, power_tx.kicad_sch]
2026-04-08 wrap up rx
    [power_rx.kicad_pcb]
2026-04-09 change things around
    [display_ctrler.kicad_pcb]
2026-04-09 cut gnd plane
    [power_rx.kicad_pcb]
2026-04-09 Edit testpoint footprint
    [power_tx.kicad_pcb]
2026-04-09 change power rx gnding, add step files of all boards
    [power_rx.kicad_pcb, power_rx.kicad_sch, rx.step, support.step]
2026-04-09 Most up to date TX
    [power_tx.kicad_pcb, power_tx.kicad_sch]
2026-04-09 adjust test point
    [power_rx.kicad_pcb, power_rx.kicad_sch, rx.step]
2026-04-09 update rx model
    [rx.step]
2026-04-11 alter rx to avoid flux lines
    [power_rx.kicad_pcb, power_rx.kicad_sch]
2026-04-11 display ctrler changes
    [display_ctrler.kicad_pcb, display_ctrler.kicad_sch]
2026-04-11 move led terminal up
    [display_ctrler.kicad_pcb]
2026-04-13 add leds
    [power_rx.kicad_pcb, power_rx.kicad_sch]
2026-04-13 FINAL PUSHES
    [display_ctrler.kicad_pcb, display_ctrler.kicad_sch, power_rx.kicad_pcb]
